SethDrake/RCLMini/pcb/rcl_mini.brd

## EAGLE design pcb/rcl_mini.brd (2019-12-12)

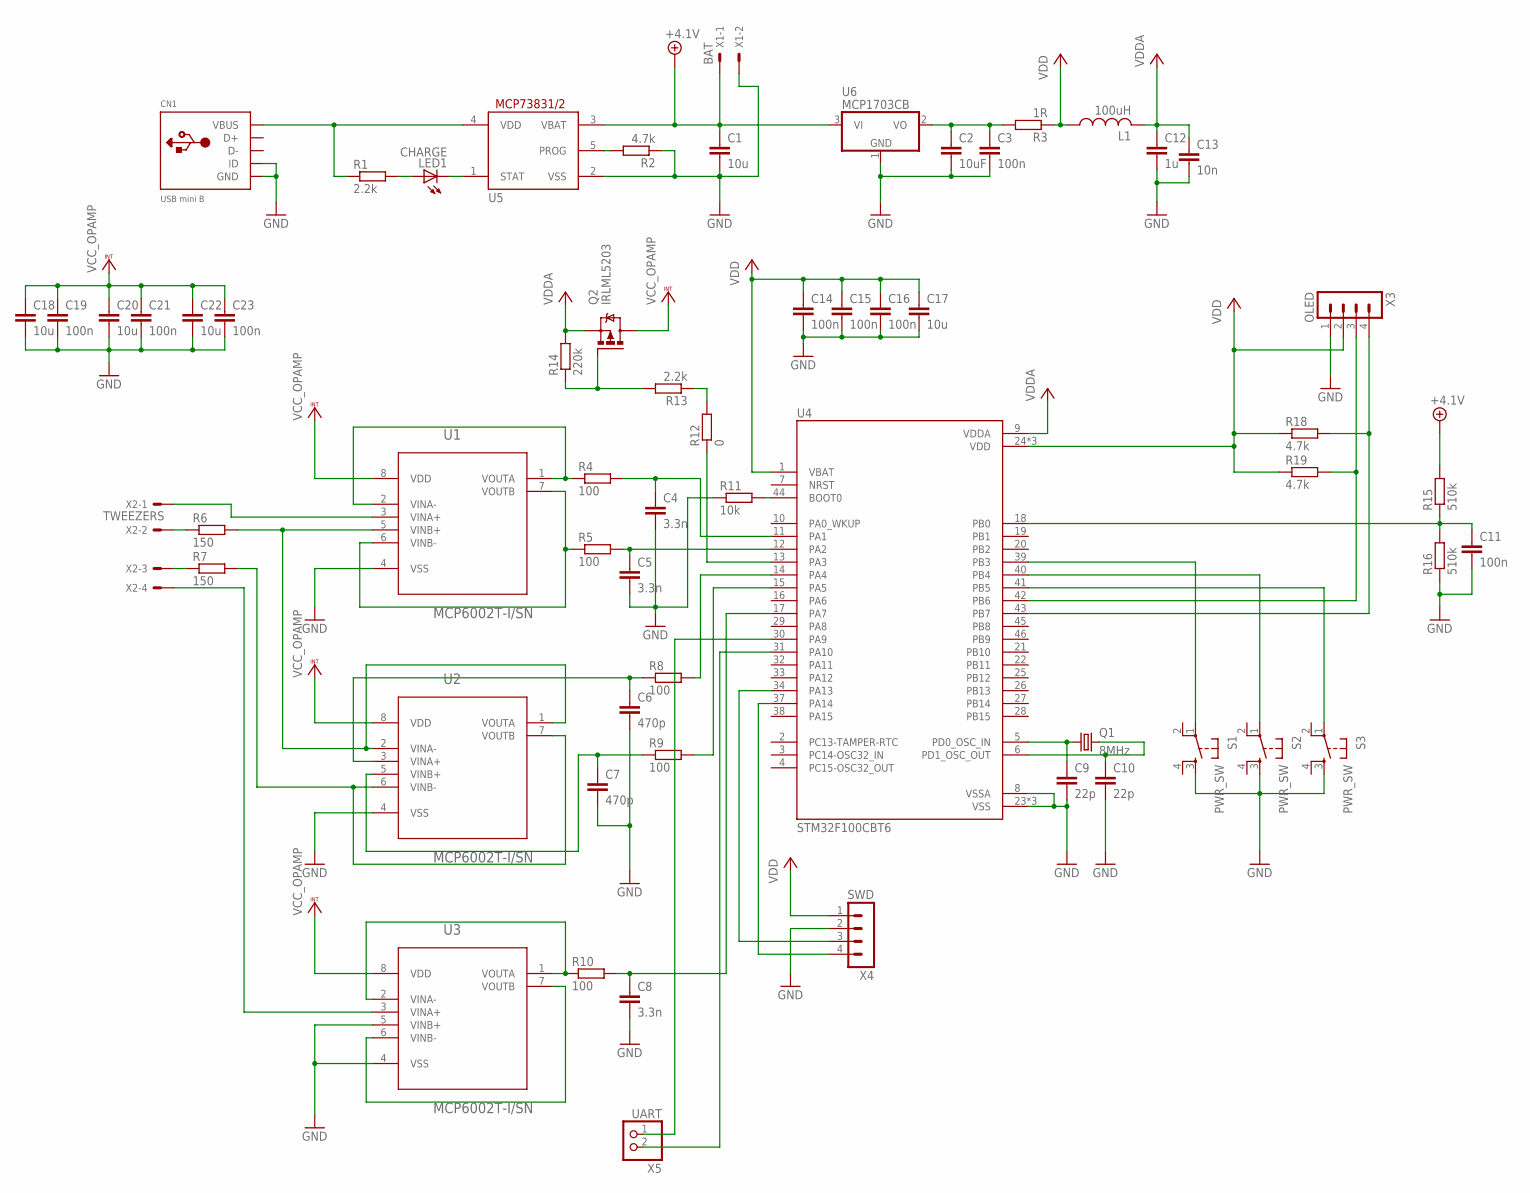
[picture p1: schematic rcl_mini.sch]

Parts:
C1, C17, C18, C20, C22: 10u; C0805
C2: 10uF; C0805
C3, C11, C14, C15, C16, C19, C21, C23: 100n; C0805
C4, C5, C8: 3.3n; C0805
C6, C7: 470p; C0805
C9, C10: 22p; C0805
C12: 1u; C0805
C13: 10n; C0805
CN1: USB mini B; USB-MINIB
L1: 100uH; L3216C
LED1: CHARGE; CHIPLED_1206
Q1: 8MHz; HC49UP
Q2: IRLML5203; MICRO3
R1, R13: 2.2k; M0805
R2, R18, R19: 4.7k; M0805
R3: 1R; M0805
R4, R5, R8, R9, R10: 100; M0805
R6, R7: 150; M0805
R11: 10k; M0805
R12: 0; R1206
R14: 220k; M0805
R15, R16: 510k; M0805
S1, S2, S3: PWR_SW; DTS-6
U1, U2, U3: MCP6002T-I/SN; SOIC127P600X175-8N
U4: STM32F100CBT6; QFP50P900X900X160-48N
U5: MCP73831/OT; SOT23-5L
U6: MCP1703CB; SOT23
UART: X5; 1X02
X1: BAT; 22-23-2021
X2: TWEEZERS; 22-23-2041
X3: OLED; MA04-1
X4: SWD; MA04-1

Connections:
GND: C1.2, C2.2, C3.2, C4.2, C5.2, C6.2, C7.2, C8.2, C9.2, C10.2, C11.2, C12.2, C13.2, C14.2, C15.2, C16.2, C17.2, C18.2, C19.2, C20.2, C21.2, C22.2, C23.2, CN1.GND, CN1.ID, R2.1, R11.1, R16.1, S1.3, S2.3, S3.3, U1.4 (VSS), U2.4 (VSS), U3.4 (VSS), U3.5 (VINB+), U4.8 (VSSA), U4.23 (VSS), U4.35 (VSS), U4.47 (VSS), U5.2 (VSS), U6.1 (GND), X1.2, X3.1, X4.2
HCUR: R7.1, X2.3
HCUR2: R7.2, U2.6 (VINB-), U2.7 (VOUTB)
HPOT: U3.3 (VINA+), X2.4
LCUR: R6.1, X2.2
LCUR2: R6.2, U1.5 (VINB+), U2.1 (VOUTA), U2.2 (VINA-)
unnamed: R12.2, R13.1
unnamed: LED1.A, R1.2
unnamed: LED1.C, U5.1 (STAT)
unnamed: R2.2, U5.5 (PROG)
unnamed: C2.1, C3.1, R3.2, U6.2 (VO)
unnamed: R4.1, U1.1 (VOUTA), U1.2 (VINA-)
unnamed: U1.3 (VINA+), X2.1
unnamed: R5.1, U1.6 (VINB-), U1.7 (VOUTB)
unnamed: C6.1, R8.1, U2.3 (VINA+)
unnamed: R11.2, U4.44 (BOOT0)
unnamed: Q2.1 (G), R13.2, R14.1
unnamed: C7.1, R9.1, U2.5 (VINB+)
unnamed: R10.1, U3.1 (VOUTA), U3.2 (VINA-)
unnamed: C11.1, R15.1, R16.2, U4.18 (PB0)
unnamed: U3.6 (VINB-), U3.7 (VOUTB)
unnamed: C9.1, Q1.1, U4.5 (PD0_OSC_IN)
unnamed: C10.1, Q1.2, U4.6 (PD1_OSC_OUT)
OLED_I2C_SCK: R19.2, U4.42 (PB6), X3.3
OLED_I2C_SDA: R18.2, U4.43 (PB7), X3.4
PA1: C4.1, R4.2, U4.11 (PA1)
PA2: C5.1, R5.2, U4.12 (PA2)
PA3: R12.1, U4.13 (PA3)
PA4: R8.2, U4.14 (PA4)
PA5: R9.2, U4.15 (PA5)
PA7: C8.1, R10.2, U4.17 (PA7)
SW1: S1.1, U4.39 (PB3)
SW2: S2.1, U4.40 (PB4)
SW3: S3.1, U4.41 (PB5)
SWCLK: U4.37 (PA14), X4.4
SWDIO: U4.34 (PA13), X4.3
UART_RX: U4.31 (PA10), UART.2
UART_TX: U4.30 (PA9), UART.1
USB+: CN1.VBUS, R1.1, U5.4 (VDD)
VBAT+: C1.1, R15.2, U5.3 (VBAT), U6.3 (VI), X1.1
VCC_OPAMP: C18.1, C19.1, C20.1, C21.1, C22.1, C23.1, Q2.3 (D), U1.8 (VDD), U2.8 (VDD), U3.8 (VDD)
VDD: C14.1, C15.1, C16.1, C17.1, L1.1, R3.1, R18.1, R19.1, U4.1 (VBAT), U4.24 (VDD), U4.36 (VDD), U4.48 (VDD), X3.2, X4.1
VDDA: C12.1, C13.1, L1.2, Q2.2 (S), R14.2, U4.9 (VDDA)

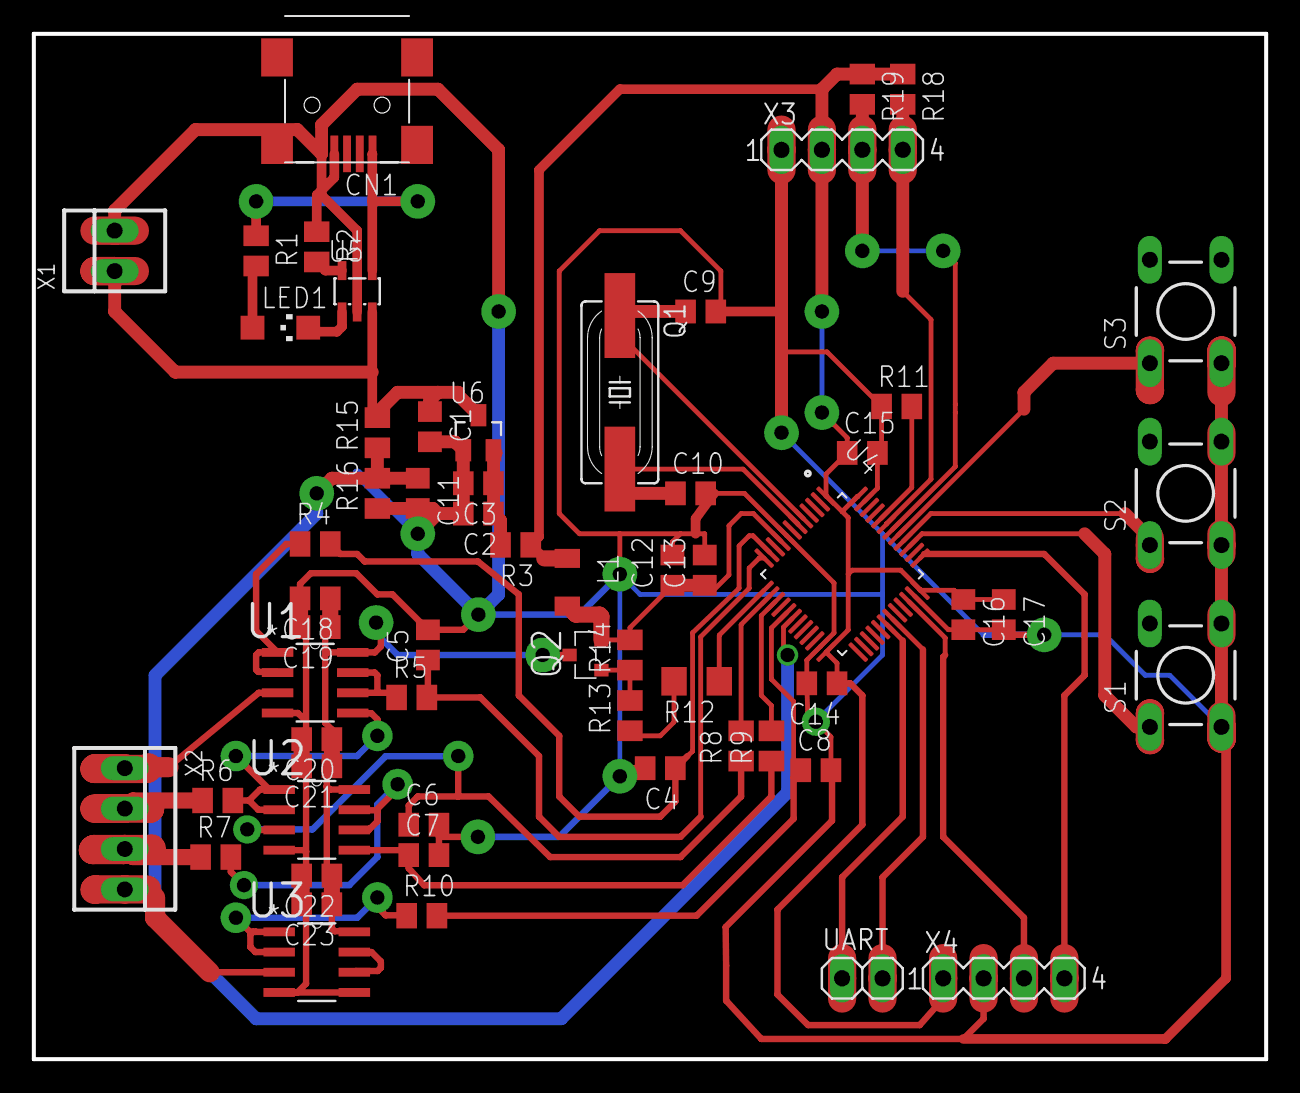
[picture p2: board rcl_mini.brd from above]

Board: 2 copper layers, 77.5 x 64.4 mm, 60 parts (0 on the bottom side), 43 nets.
