SethDrake/RCLMini/firmware/RCLMini/drivers/inc/lcd_generic_font.h

/* Generic font for LCD */

/* { */

#ifndef __LCD_FONT_H__
#define __LCD_FONT_H__
	/* { */

#include "stm32f10x_conf.h"

const unsigned char numbers[] =
{

		0b00000001, 0b11111111, 0b11111000, //   ##############
		0b00000011, 0b11111111, 0b11111100, //  ################
		0b00000111, 0b00000000, 0b00001110, // ###            ###
		0b00000110, 0b11100000, 0b00000110, // ## ###          ##
		0b00000110, 0b00011100, 0b00000110, // ##    ###       ##
		0b00000110, 0b00000011, 0b10000110, // ##       ###    ##
		0b00000110, 0b00000000, 0b01110110, // ##          ### ##
		0b00000111, 0b00000000, 0b00001110, // ###            ###
		0b00000011, 0b11111111, 0b11111100, //  ################
		0b00000001, 0b11111111, 0b11111000, //   ##############

		0b00000000, 0b00000000, 0b00000000, //
		0b00000000, 0b00000000, 0b00000000, //
		0b00000110, 0b00000000, 0b00001000, // ##             #
		0b00000110, 0b00000000, 0b00001100, // ##             ##
		0b00000111, 0b11111111, 0b11111110, // ##################
		0b00000111, 0b11111111, 0b11111110, // ##################
		0b00000110, 0b00000000, 0b00000000, // ##
		0b00000110, 0b00000000, 0b00000000, // ##
		0b00000000, 0b00000000, 0b00000000, //
		0b00000000, 0b00000000, 0b00000000, //

		0b00000111, 0b00000000, 0b00111000, // ###          ###
		0b00000111, 0b10000000, 0b00111100, // ####         ####
		0b00000111, 0b11000000, 0b00001110, // #####          ###
		0b00000110, 0b11100000, 0b00000110, // ## ###          ##
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
		0x7C, 0x14, 0x14, 0x14, 0x08,// 70 p
		0x08, 0x14, 0x14, 0x18, 0x7C,// 71 q
		0x7C, 0x08, 0x04, 0x04, 0x08,// 72 r
		0x48, 0x54, 0x54, 0x54, 0x20,// 73 s
		0x04, 0x3F, 0x44, 0x40, 0x20,// 74 t
		0x3C, 0x40, 0x40, 0x20, 0x7C,// 75 u
		0x1C, 0x20, 0x40, 0x20, 0x1C,// 76 v
		0x3C, 0x40, 0x30, 0x40, 0x3C,// 77 w
		0x44, 0x28, 0x10, 0x28, 0x44,// 78 x
		0x0C, 0x50, 0x50, 0x50, 0x3C,// 79 y
		0x44, 0x64, 0x54, 0x4C, 0x44,// 7a z
		0x00, 0x08, 0x36, 0x41, 0x00,// 7b <
		0x00, 0x00, 0x7F, 0x00, 0x00,// 7c |
		0x00, 0x41, 0x36, 0x08, 0x00,// 7d >
		0x10, 0x08, 0x08, 0x10, 0x08,// 7e Right Arrow ->
		0x78, 0x46, 0x41, 0x46, 0x78,// 7f Left Arrow <-
};



	/* } */
#endif

/* } */
