SethDrake/RCLMini/firmware/RCLMini/drivers/src/uart.c

#include "uart.h"
#include "stm32f10x.h"
//-------------------------------------------------------------------
void initUART()
{
	USART1->CR1 |= USART_CR1_UE; //Включаем USART1
	USART1->CR1 &= ~USART_CR1_M; //Длина слова - 8 бит
	USART1->CR2 &= ~USART_CR2_STOP; //1 стоп-бит
	USART1->BRR = 278;//@32//139;//115200 @160000 //104; //115200 @ 12M
	USART1->CR1 |= USART_CR1_TE; //Разрешаем передачу данных
//	USART1->CR1 |= USART_CR1_RE; //Разрешаем прием данных
}
//-------------------------------------------------------------------
void uart_tx(const char* str, int wait)
{
	while(*str != 0 )
	{
	uartSendByte(*str++);
	}

}
//-------------------------------------------------------------------
void uartSendByte(uint8_t c) {
	while(!(USART1->SR & USART_SR_TC));
	  USART1->DR = c;

}
//-------------------------------------------------------------------
