SethDrake/RCLMini/(commit log)

2019-11-09 pcb v1.0
    [rcl_mini.sch]
2019-11-14 pcb v1.0 completed
    [rcl_mini.brd]
2019-11-16 adopted firmware from Nikitos https://radiokot.ru/circuit/digital/measure/108/ https://drive.google.com/drive/folders/0B6ejWgMiaZIvfm1nM1FLalNya0xEcTRqZkZqQ01XcEJ2UTZBb014Ym9majBQMXFZc2xYTW8
2019-12-12 mcp6002 package was changed from msop to soic
    [rcl_mini.brd, rcl_mini.sch]
2019-12-12 pcb design improvements
    [rcl_mini.brd]
